RDPOLL/BTG/README.md

BTG  - Batterie Test Gerät

This is to test Battery packs under predefined current, if they reach a certain voltage.
