RDPOLL/BTG/Doku/BTG_Doku/Dokumentation_BTG.docx

Lucas Pollak

Lucas.pollak@ruag.ch

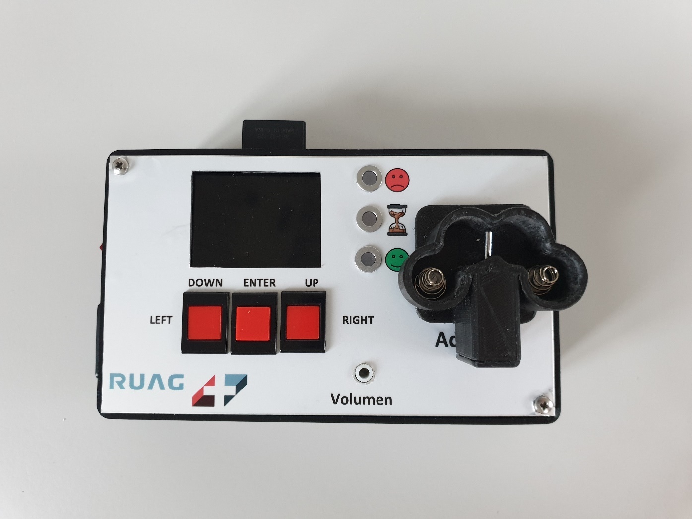
[picture p1: figure]

Batterietestgerät

# 1 Auftrag

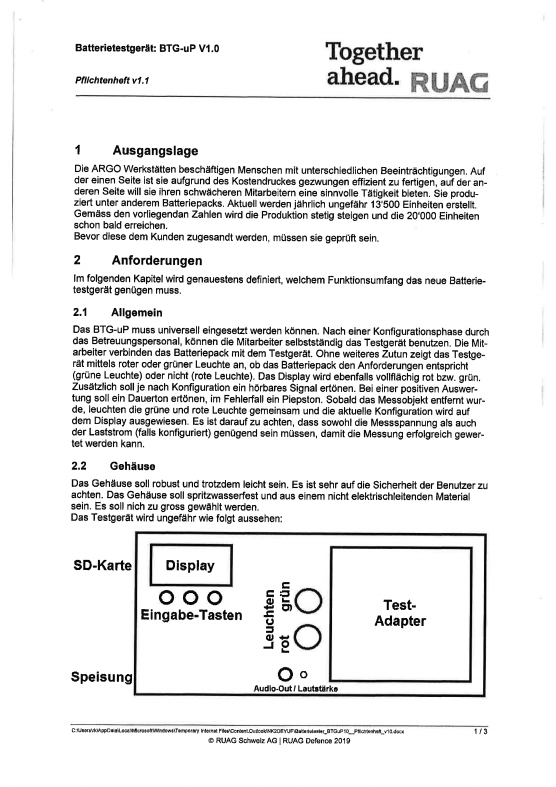
[picture p2: figure]

## 1.1 Pflichtenheft

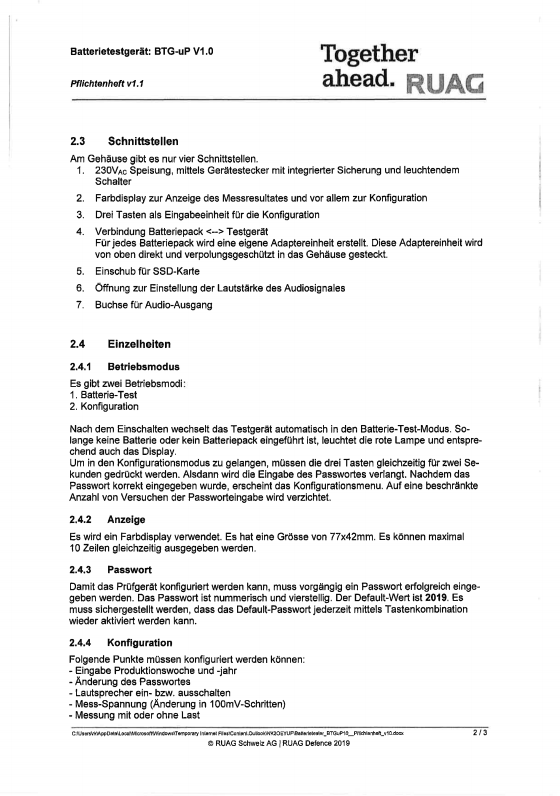
[picture p3: figure]
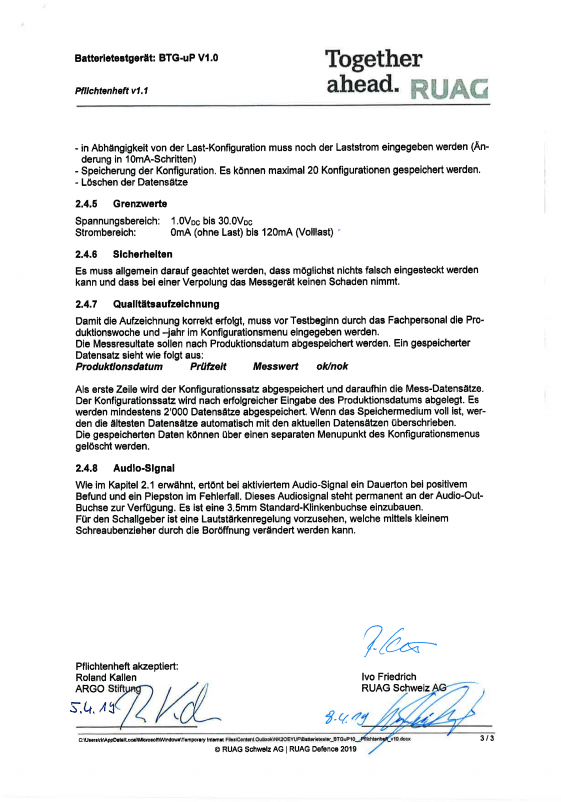
[picture p4: figure]

# 2 Produkt

Das fertige Produkt besteht aus dem Batterietestgerät und der dazugehörigen Software. Dieses Batterietestgerät muss ein Akkupack auf dessen Spannung und Strom überprüfen. Die Akkupacks werden von der AROG Stiftung gefertigt. Das Batterietestgerät sollte aber nicht auf ein Batterietyp festgelegt sein, sondern kann durch einen austauschbaren Messadapter auch verschiedene Batterietyps messen. Nach dem Messen müssen die Messergebnisse auf einem Datenträger abgespeichert werden können.

## 2.1 Hardware

In diesem Abschnitt wird der Hardwareteil des Produktes näher erklärt.

### 2.1.1 Schnittstellen

Zur Bedienung hat das BTG einige Schnittstellen. Zum einen zur Steuerung des Gerätes aber auch zur Stromversorgung.

#### 2.1.1.1 230V

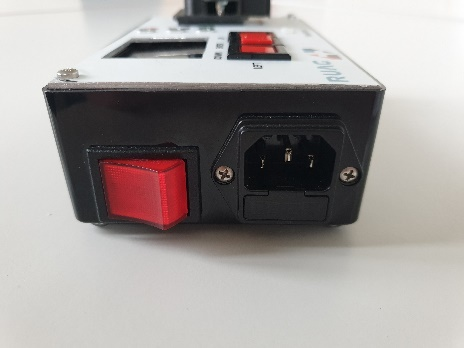
[picture p5: figure]

Die 230 Volt Stromversorgung besteht aus einem Apparatestecker mit integrierten überstromschmelztsicherung. Ein und Aus geschaltet wird das Gerät über den Netzschalter. Dieser trennt das gesamte Gerät von der Speisung. Jegliche Veränderungen an der Speisung müssen mit Abgeschaltetem Gerät getätigt werden.

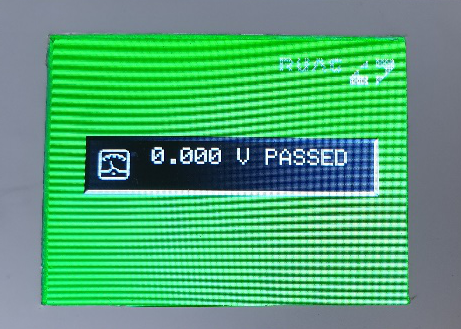
[picture p6: figure]

#### 2.1.1.2 Display

Das Display zeigt den aktuellen Status des Gerätes an. Es werden beim aufstarten allfällige Fehler angezeigt. Wenn das BTG auf eine Batterie wartet zeigt dies das Display auch an. Zum Schluss wird nach einer Messung wird das Ergebnis auf dem Display ausgegeben. Das Display wird vom uC über SPI angesteuert.

#### 2.1.1.3 SD-Karte

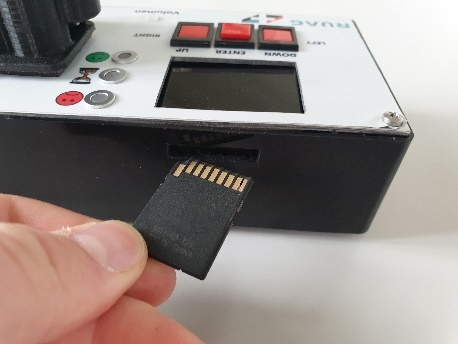
[picture p7: figure]

Der SD-Karten Stecker ist an der Oberseite des Batterietestgerätes erreichbar. (Siehe Bild) Hier muss zur Messung einer Batterie eine SD-Karte mit einem Initialisationsfile (Siehe Bedienungsanleitung) eingesteckt sein. Aufgrund des Aufbaues des SD-Karten Steckers müssen Veränderungen an der SD-Karten (ein- und ausstecken) im Ausgeschalteten Zustand getätigt werden. Ansonsten kann es zu Datenverlusten kommen.

#### 2.1.1.4 Taster & LEDs

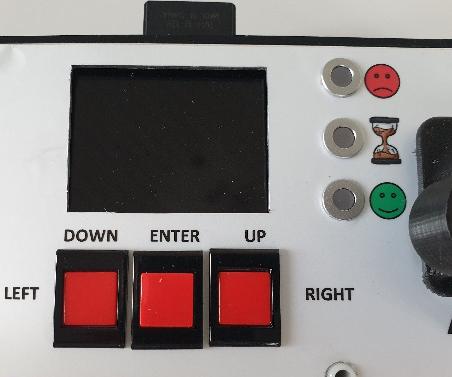
[picture p8: figure]

Zur Steuerung des Gerätes wird ein Taster und drei LEDs verwendet. Optisch sieht es aus als hätte es drei Taster, allerdings ist nur der in der Mitte funktionsfähig. Die äusseren beiden wurden aufgrund ästhetischer Zwecke nicht entfernt. Obwohl der mittler Taster funktionsfähig ist, wird er in der aktuellen Software Version nicht verwendet. Er kann für den Fall in zukünftigen Versionen benutzt werden.

Die drei LEDs haben die Farben Rot, Orange und Grün und werden zur Statusanzeige verwendet. (Siehe Bedienungsanleitung)

#### 2.1.1.5 Messadapter

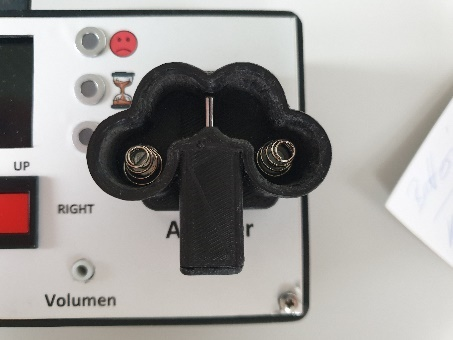
[picture p9: figure]

Zur Messung einer Batterie wird ein Adapter benötigt. Dieser Adapter besteht aus zwei Polen und einem Schalter. Wenn die Batterie in den Messadapter genug tief eingesteckt ist, wird der Schalter betätigt und dadurch die Messung gestartet. Dieser Messadapter kann nach Bedarf ausgetauscht werden, um eine andere Batterie zu messen. Das Layout des Messadaptersteckes ist in Schema ersichtlich.

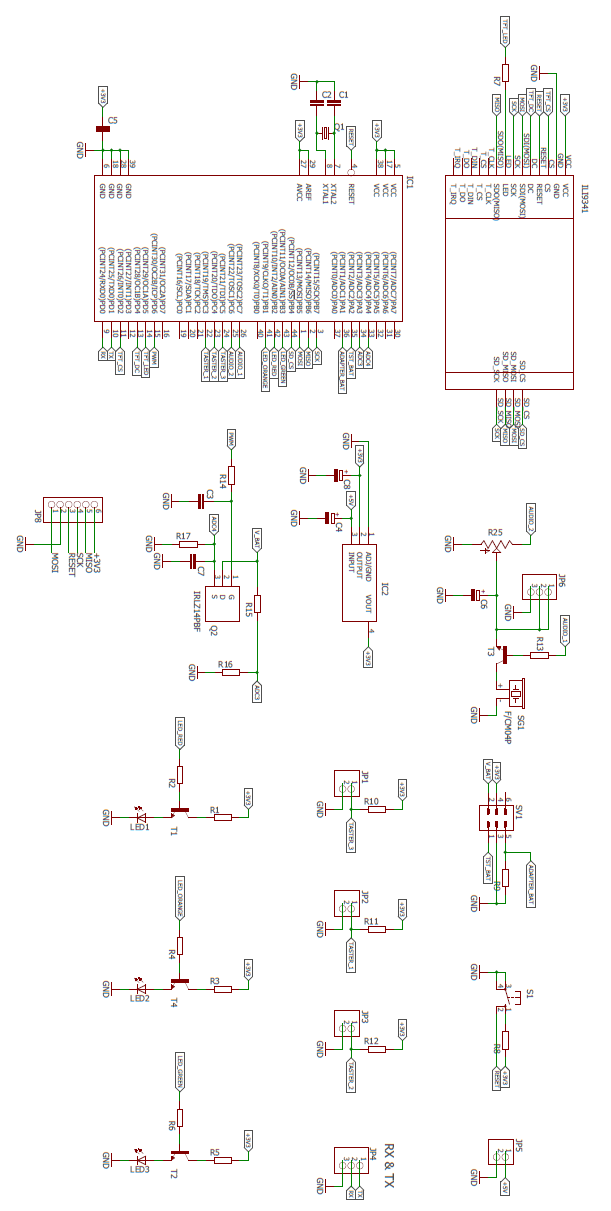
[picture p10: figure]

### 2.1.2 Schema

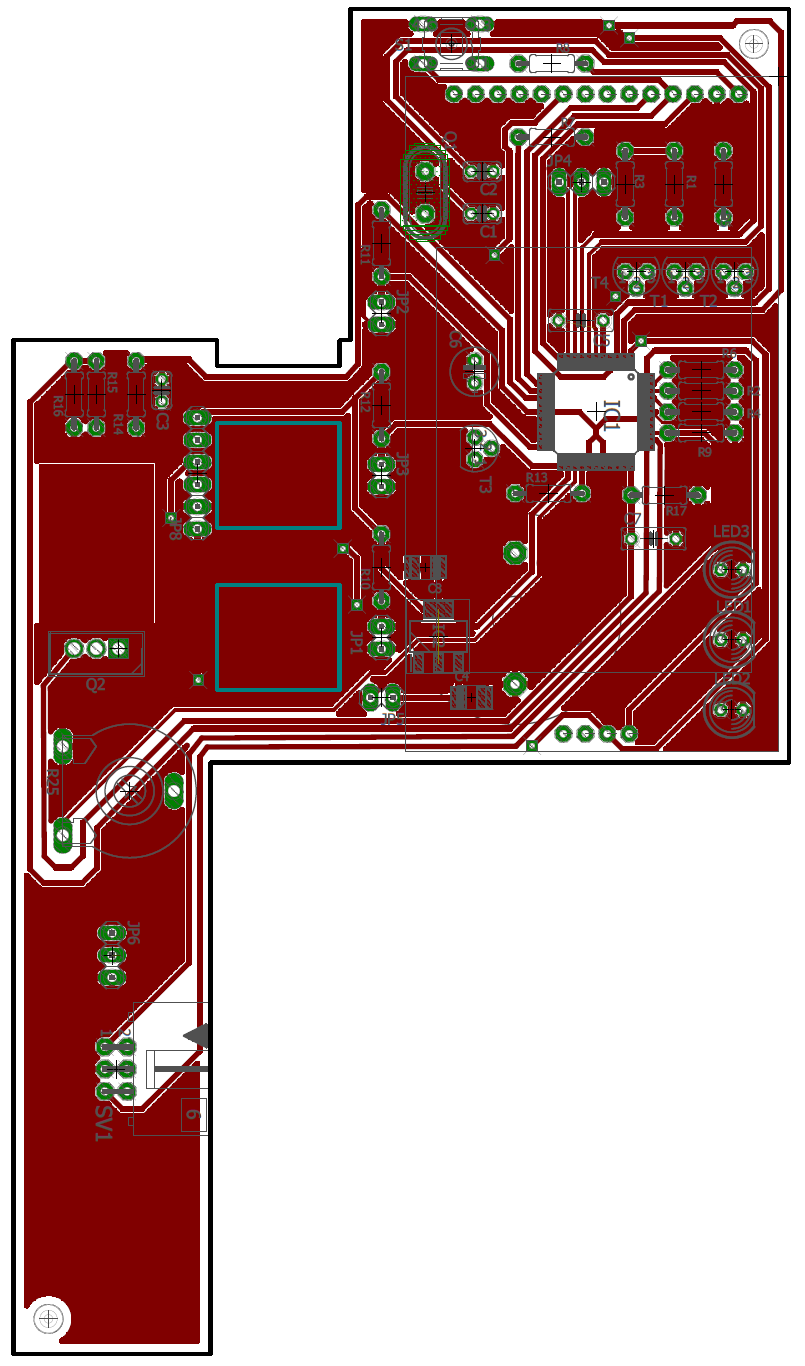
[picture p11: figure]

### 2.1.3 Layout

Top Layer

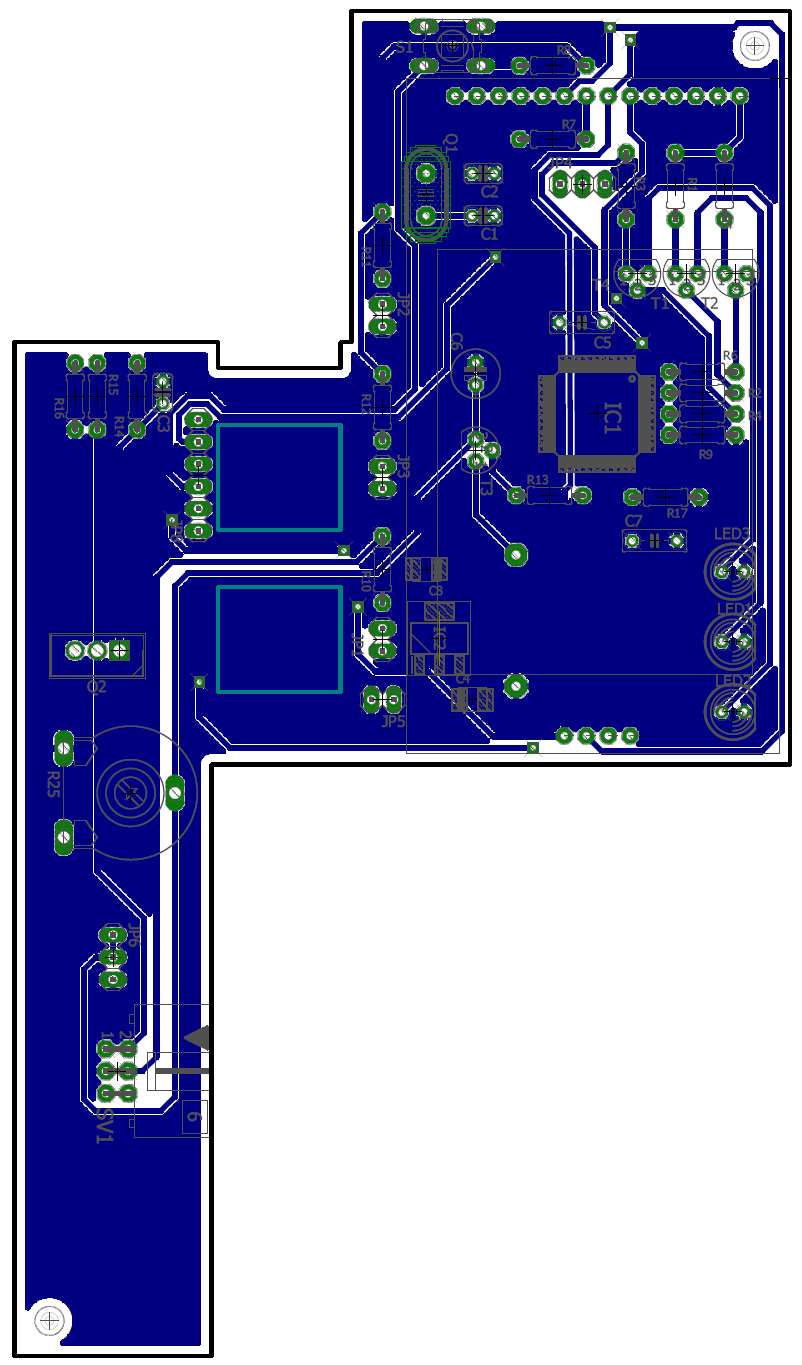
[picture p12: figure]

Bottom Layer

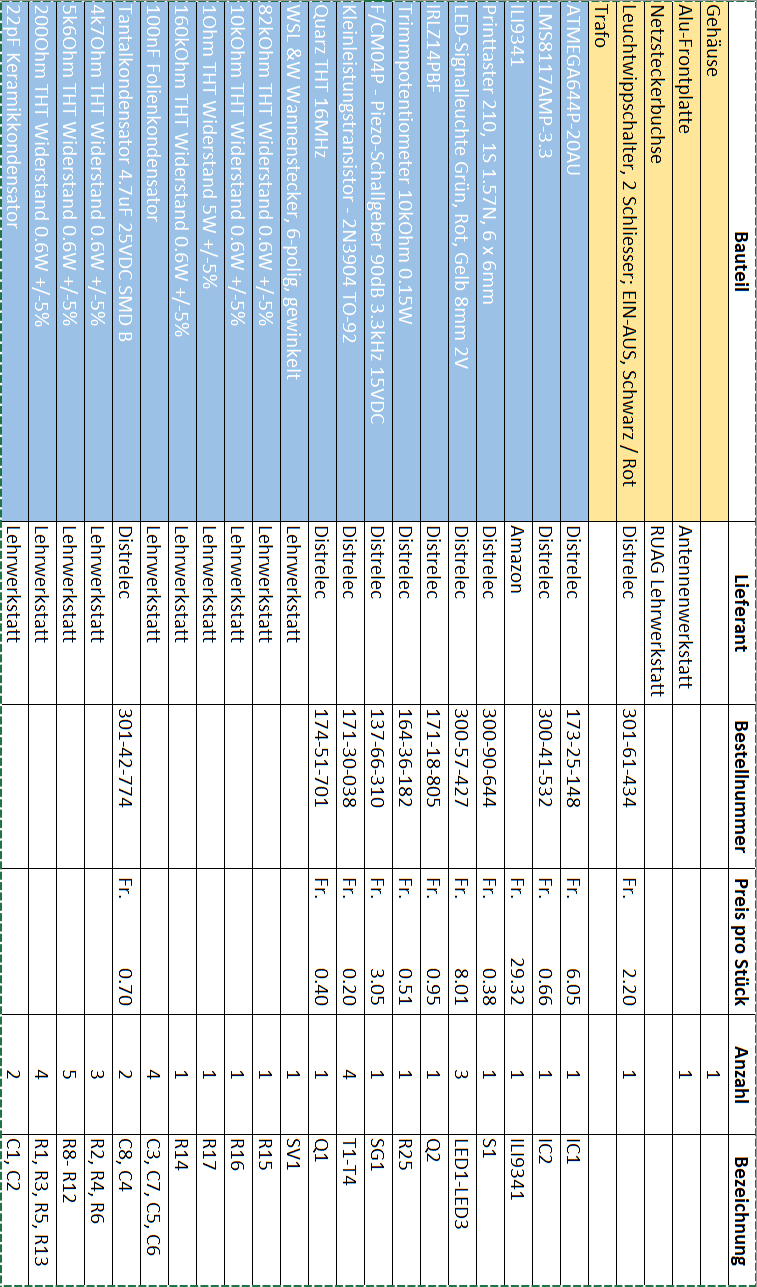
[picture p13: figure]

### 2.1.4 Bauteilliste

## 2.2 Software

### 2.2.1 Werdegang

Da die vorherige Software Version nicht vollständig war, musste diese überarbeitet werden. Die Aktuelle Version wurde von Grund auf neu geschrieben. Nur einzelne Teile wie die Port Initialisierung wurde von der alten übernommen.

Zuerst wurde versucht das Display richtig anzusteuern. Hier wurde festgestellt das in der alten Version die SPI Schnittstelle falsch initialisiert worden war. Als dies behoben wurde lief das Display viel flüssiger. Anschließend wurden Funktionen für die Text und Bild Ausgabe auf dem Display geschrieben und getestet. Somit wurde die ganze grafische Ausgabe effizienter und weniger Fehler anfällig.

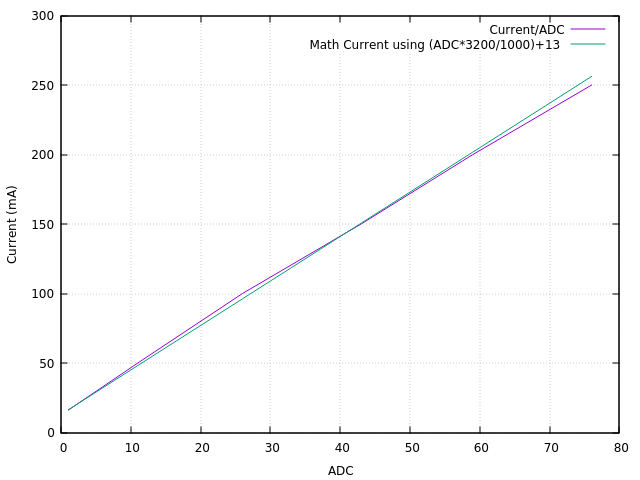
[picture p14: figure]
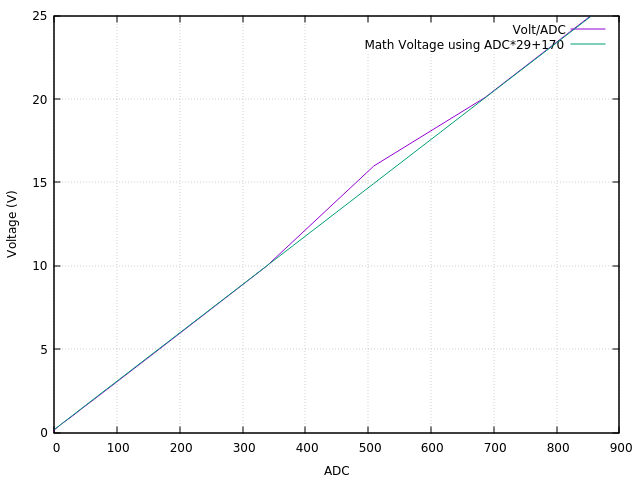
[picture p15: figure]

Im zweiten Schritt wurde Ansteuerung der Messschaltung programmiert. Es wurden die Abhängigkeiten zwischen den ADC und der realen Spannung aufgezeichnet. Anhand dessen konnten die Fehler der ADCs besser kompensiert werden.

Diese Grafiken zeigen den Verlauf der beiden ADC im vergleich zu dem Ergebnis der internen Berechnung der Spannung und des Stromes. Mit Hilfe dieser Formel wird das Messergebnis etwas genauer. Eine ähnliche Messung wurde für das Verhältnis zwischen dem PWM Ausgang und dem Laststrom gemacht. Bei dieser Messung wurde festgestellt, dass der Laststrom verlauf sehr linear im Verhältnis zum PWM Ausgang steht. Aufgrund dessen konnte eine Tabelle erstellt werden, nach welcher der uC den ersten Laststrom setzt. Nach dieser ersten Setzung des PWM Wertes wird dieser anhand des gemessenen Stromes geregelt.

Als letztes wurde die SD-Karte integriert. Als Bibliothek für die SD-Karte wurde die «FatFs - Generic FAT Filesystem Module (http://elm-chan.org/fsw/ff/00index_e.html)» Bibliothek verwendet. Nach dessen Integration konnte die SD-Karte erfolgreich beschrieben und ausgelesen werden. Mit dieser Möglichkeit wurde beschlossen, dass das interne Konfigurationsmenü wegfällt und alles auf die SD-Karte ausgelagert wird. Das bedeutet, dass auf der SD-Karte alle nötigen Konfigurationsdaten in einem File gespeichert werden. Dieses File wird beim aufstarten des BTG ausgelesen und verarbeitet. Mehr zu den nötigen Inhalten dieses Files ist in der Bedienungsanleitung zu finden. Mit dieser Herangehensweise fällt auch ein Passwort für die Konfiguration weg, denn es braucht einen externen Computer, um die Konfigurationsdaten zu ändern.

Der strukturelle Ablauf des Programmes ist auf der nächsten Seite zu finden. Dieses Diagramm sollte helfen den Code zu verstehen.

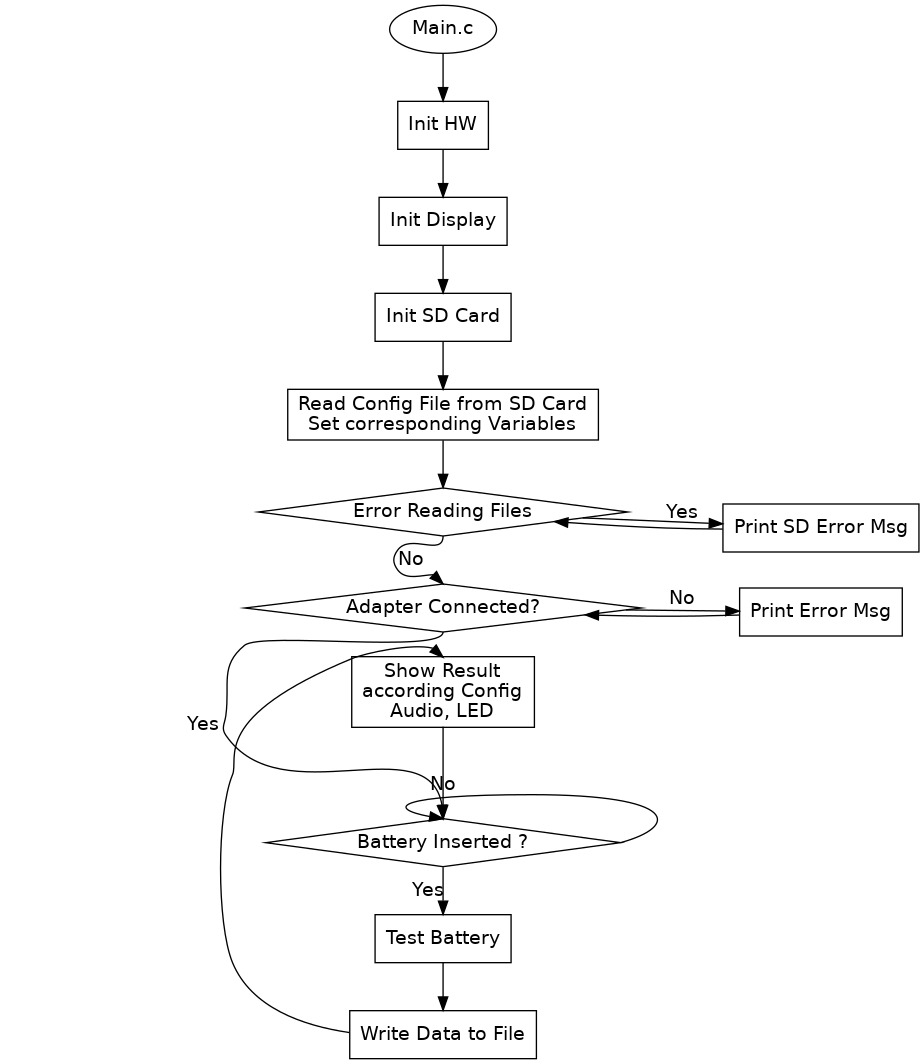
[picture p16: figure]

### 2.2.2 Struktur

# 3 Dokumente

## 3.1 Bedienungsanleitung

### 3.1.1 Wichtige Hinweise

Jegliche Manipulationen mit der SD-Karte müssen bei abgeschalteten Batterietestgerät getätigt werden. Ansonsten kann es zu Datenverlusten kommen.

Die Tasten UP, DOWN und ENTER werden nicht verwendet.

### 3.1.2 Ein-/Ausschalten

Auf der linken Seite der Batterietestgerätes befindet sich eine Apparatesteckerbuchse. In diese wird ein Apparatekabel zur Speisung eingesteckt. Neben der Apparatesteckerbuchse ist der Hauptschalter.

### 3.1.3 Konfiguration

Als erstes entnimmt man die SD-Karte dem abgeschaltetem Batterietestgerät und öffnet mittels eines Computers das read.ini File (siehe SD-Karten Files). In diesem File werden alle nötigen Einstellungen gemacht. Anschliessend wird die SD-Karte vom Computer entfernt und beim abgeschaltetem Batterietestgerät eingesteckt. Das Testgerät wird wieder eingeschaltet und liest automatisch die zuvor definierten Werte ein. Wenn aktiviert, kann die Lautstärke des Piepsers über den Drehwiderstand verändert werden. Hierfür muss ein Schlitzschraubenzier in die Öffnung «Volumen» gesteckt werden.

### 3.1.4 Messung

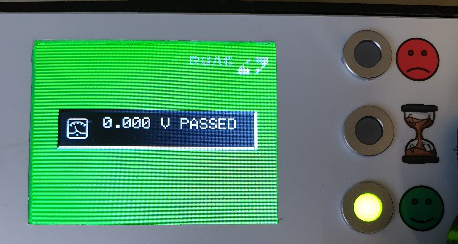
[picture p17: figure]

Das Batterie-Pack wird in den Messadapter vorsichtig eingeführt. Mit einem leichten Druck und dem hör- und spürbarem Klicken des Schalters wird eine Messung gestartet. Die Batterie muss solange gedrückt gehalten werden, bis das Gerät das Ergebnis ausgibt. Während der Messung leuchtet die Orange/Rote LED neben der Sanduhr.

### 3.1.5 Richtiges Messergebnis

Wenn die Batteriespannung über der zuvor definierten Spannung liegt, wird der Bildschirm grün und die grüne LED neben dem lachenden Gesicht leuchtet auf. Zusätzlich kann die akustische Ausgabe aktiviert sein, wodurch bei einem richtigen Messergebnis einen Dauerton ausgeben wird.

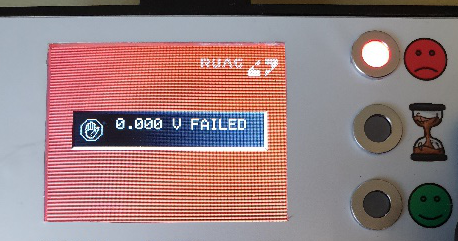
[picture p18: figure]

### 3.1.6 Falsches Messergebnis

Wenn die Batteriespannung unter der definierten Spannung liegt, wird der Bildschirm Rot und die rote LED neben dem traurigen Gesicht leuchtet auf. Auch hier wird, wenn zuvor definiert, ein akustisches Signal ausgegeben. Bei einen Falschen Messergebnis wird ein pulsierender Ton ausgegeben.

### 3.1.7 SD-Karten Files

#### 3.1.7.1 Beschreibung

##### 3.1.7.1.1 Read.ini

Das Batterietestgerät braucht auf der SD-Karte nur das read.ini File. In diesem werden alle Einstellungen definiert.

week = aktuelle Kalenderwoche

year = aktuelles Jahr

name = Name des Angestellten

piezo = akustische Ausgabe aktiv (1) oder nicht aktiv (0)

voltage = Sollspannung der Batterie in mV

current = Laststrom in mA einstellen (für keine Last auf 0 setzen)

Alle nicht erwähnten Werte wie «debug und pwm_offset» sind für Entwicklung zwecke und sollte nicht verändert werden.

##### 3.1.7.1.2 Res.csv

Das Gerät erstellt, falls noch nicht vorhanden, ein Res.csv File. In diesem werden alle Messungen folgen dokumentiert.

Name | Jahr | Kalenderwoche | Laststrom in mA | Gemessene Spannung in mV | Failed/Passed

Beispiel:

Max Muster | 2020 | 46 | 50 | 6115 | Failed

Die Messungen werden nacheinander gespeichert (erste Messung zuoberst). Falls nötig kann das Res.csv File auch gelöscht werden. Das Batterietestgerät erstellt bei der ersten Messung wieder ein Neues File.

#### 3.1.7.2 Read.ini Beispiel File

week = 46

#week number

year = 2020

# year number

name = Max Muster

#name of the user

piezo = 1

debug = 0

pwm_offset = 150

voltage = 10000

current = 50

# 4 Quellenverzeichnis

## 4.1 Code

Der Code ist unter dieser Webseite (https://github.com/RDPOLL/BTG) zu finden:

## 4.2 Dokumentation

Die Dokumentation inklusive Schema und Layout befinden sich im Unterordner Doku (https://github.com/RDPOLL/BTG/tree/main/Doku) auf Github.

Die Dokumentation zur SD-Karten Bibliothek befindet sich auf dieser Webseite (http://elm-chan.org/fsw/ff/00index_e.html).
