RDPOLL/BTG/Doku/BTG_Doku/Gehäuse/Folie_V2.pdf

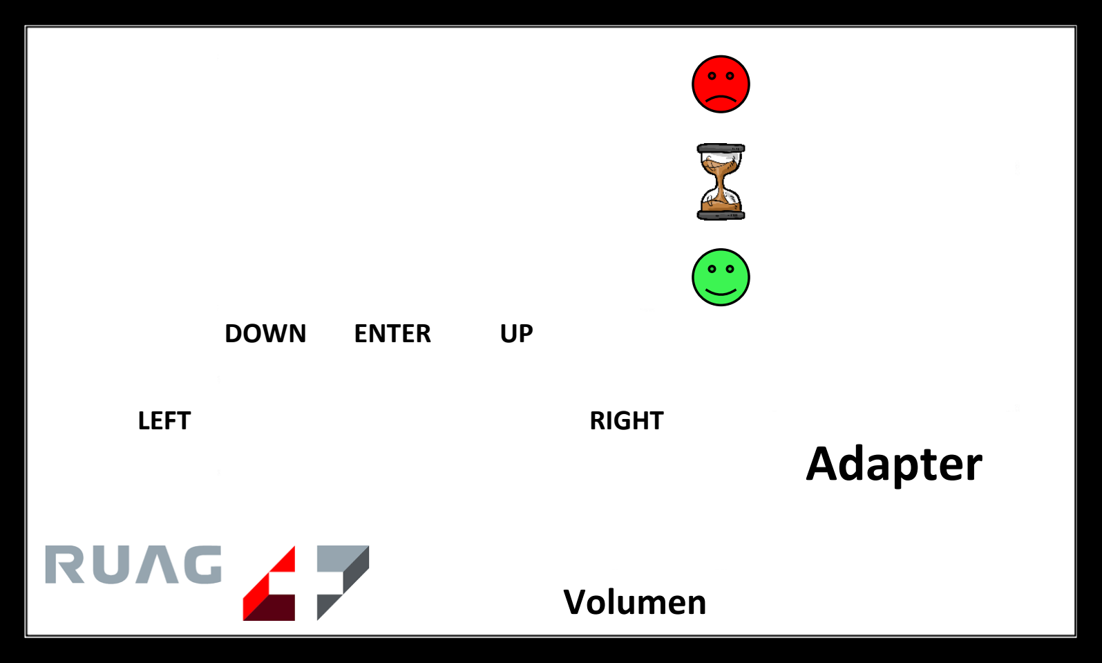
[picture p19: figure]
Adapter; Volumen; DOWN; ENTER; LEFT; RIGHT
