RDPOLL/BTG/Doku/BTG_Doku/Vorlagen_Auftragsgeber/Pflichtenheft.pdf

Batterietestgerät: BTG-uP Vl.0

Pfllchtenheft v|.1

# Together

# ahead. RUAG

## I Ausgangslage

Die ARGO Werkstätten beschäftigen Menschen mit unterschiedlichen Beeinträchtigungen. Auf der einen Seite ist sie aufgrund des Kostendruckes gezwungen effizient zu fertigen, auÍ der anderen Seite willsie ihren schwächeren Mitarbeitern eine sinnvolle Tåitigkeit bietèn. Sie produziert unter anderem Batteriepacks, Aktuell werden jährlich ungefähr 13'500 Einheiten erstellt, Gemäss den vorliegendan Zahlen wird die Produktion stetig steigen und die 2O'OOO Einheiten schon bald erreichen.
Bevor diese dem Kunden zugesandt werden, müssen sie geprüft sein.

## 2 Anforderungen

lm folgenden Kapitelwird genauestens definiert, welchem Funktionsumfang das neue Batterietestgerät genügen muss,

### 2.1 Allgemein

Das BTG-uP muss universell eingesetzt werden können. Nach einer Konfigurationsphase durch das Betreuungspersonal, können die Mítarbeiter selbstständig das Testgerät benutzen, Die Mitarbeiter verbinden das Batteriepack mit dem Testgerät. Ohne weiteres Zutun zeigt das Testgerät mittels roter oder grilner Leuchte an, ob das Batteriepack den Anforderungen entspricht

(grüne Leuchte) oder nicht (rote Leuchte). Das Display wird ebenfalls vollflächig rot bzw. grün. Zusätzlich sollje nach Konfiguration ein hÖrbares Signal ertönen. Bei einer positiven Auswertung soll ein Dauerton ertönen, im Fehlerfall ein Piepston. Sobald das Messobjekt entfernt wurde, leuchten die grûne und rote Leuchte gemeinsam und die aktuelle Konfígurâtion wird auf dem Dísplay ausgewiesen, Es ist darauf zu achten, dass sowohldie Messspannung als auch der Laststrom (falls konfiguriert) genügend sein müssen, damit die Messung erfolgreich gewertet werden kann.
2.2 Gehäuse

Das Gehäuse soll robust und trotzdem leicht sein. Es ist sehr auf die Sicherheit der Benutzer zu achten. Das Gehäuse soll spritzwasserfest und aus einem nicht elektrischleitenden Material sein. Es soll nich zu gross gewählt werden.
Das Testgerät wird ungefähr wie folgt aussehen:

## SD-Karte

## Speisung

## Test-

## Adapter

## Display

tr
E¡J
#b

o
J
-3H
o o

Audio-Out I Lautstärka

# ooo

## Eingabe-Tasten

Clusor8vklqppDåtê\Lo€lv\rlc¡o3off\Wndow6\Tomporâry lnternet Filos\Conlenl.Oullook\NK2OEYUF\BatterletóstgLBlcuPlo_pfllch(enhett-vl 0docx
@ RUAG Schweiz AG I RUAG Defence 2019

1t3

Batterietestgerät: BTG-uP V1 .0

Pflìchtenheft v1.1

# Together

# ahead.RUAC

### 2.3 Schnittstellen

Am Gehäuse gibt es nur vier Schnittstellen.
1, 230V¡c Speisung, mittels Gerätestecker mit integrierter Sicherung und leuchtendem Schalter
2. Farbdisplay zur Anzeige des Messresultates und vor allem zur Konfiguration
3, Drei Tasten als Eingabeeinheit für die Konfiguration
4. Verbindung Batteriepack <--> Testgerät
Für jedes Batteriepack wird eine eigene Adaptereinheit erstellt, Diese Adaptereinheit wird von oben direkt und verpolungsgeschritzt in das Gehäuse gesteckt,
5. Einschub für SSD-Karte
6. Öffnung zur Einstellung der Lautstärke des Audiosignales
7. Buchse für Audio-Ausgang

2.4 Einzelheiten

2.4.'l Betriebsmodus

Es gibt a¡rei Betriebsmodi
l. Batterie-Test
2. Konfiguration

Nach dem Einschalten wechselt das Testgerät automatisch in den Batterie-TesþModus. Solange keíne Batterie oder kein Batteriepack eingeflihrt ist, leuchtet die rote Lampe und entsprechend auch das Display,
Um in den Konfigurationsmodus zu gelangen, müssen die drei Tasten gleichzeitig für zwei Sekunden gedrtlckt werden. Alsdann wird die Eingabe des Passwortes verlangt. Nachdem das Passwort konekt eingegeben wurde, erscheint das Konfigurationsmenu. Auf eine beschränkte Anzahl von Versuchen der Passworteingabe wird vezichtet.
2.4.2 Anzeige

Es wird ein Farbdisplay verwendet. Es hat eine Grösse von77x42mm, Es können maximal 10 Zeilen gleichzeitig ausgegeben werden,
2.4.3 Passwort

Damit das Prüfgerät konfiguriert werden kann, muss vorgängig ein Passwort erfolgreich eingegeben werden. Das Passwort ist nummerisch und vierstellig, Der Default-Wert ist 2019. Es muss sichergestellt werden, dass das Default-Passwort jederzeit mittels Tastenkombination wieder aktiviert werden kann.
2.4.4 Konfiguration

Folgende Punkte müssen konfiguríert werden können:
- Eingabe Produktionswoche und -jahr
-,Anderung des Passwortes
- Lautsprecher ein- bzw. ausschalten
- Mess-spannung (Anderung in 1OOmV-schritten)
- Messung mit oder ohne Last

ClUs€ËVk\AppDEta\Lo€l\f\¡lrcsoflNvlndowr\T6mporary lntsrnÊt Flles\Conlenl.Oullook\NK2OEYUF\Bstl€letest€r-BTGUPIO_Pll¡chlênhslt-v10-dod
@ RUAG Schweiz AG IRUAG Defence 2019

Batterletestgerät: BTG-uP Vl.0

Pfllchtenhelt v1,1

# Together

# ahead.F1UAG

- in Abhångigkeit von der Last-Konfiguration muss noch der Laststrom eingegeben werden (Änderung in I OmA-Schritten)
- Speicherung der Konfiguration. Es können maximal 20 Konfigurationen gespeichert werden.
- Löschen der Datensätze
2,4.6 Grenarerte
Spannungsbereich: 1.OVoc bis30.0Voc
Strombereich: OmA (ohne Last) bis 120m4 (Volllast) "
2.4.6 Slcherhelten

Es muss allgemein darauf geachtet werden, dass möglichst nichts falsch eingesteckt werden kann und dass bei einer Verpolung das Messgerät keinen Schaden nimmt,
2.4.7 Qualltätsaufzelchnung

Damit die Aufzeichnung korrekt erfolgt, muss vor Testbeginn durch das Fachpersonal die Produktionswoche und -jahr im Konfigurationsmenu elngegeben werden.
Die Messresultate sollen nach Produktionsdatum abgespeichert werden. Ein gespeicherter Datensatz sieht wie folgt aus:

## Produktlonsdatum Prllfzelt Messwert oklnok

Als erste Zeile wird der Konfigurationssatz abgespeichert und daraufhin die Mess-Datensätze. Der Konfigurationssatz wird nach erfolgreicher Eingabe des Produktionsdatums abgelegt. Es werden mindestens 2'000 Datensåtze abgespeichert. Wenn das Speichermedium voll ist, werden die ältesten Datensåtze automatisch mit den aktuellen Datensåtzen überschrieben.
Die gespeicherten Daten können flber einen separaten Menupunkt des Konfigurationsmenus gelöscht werden.
2.4,8 Audlo-Slgnal

Wie im Kapitel 2.1 erwähnt, ertönt bei aktíviertem Audio-Signal ein Dauerton bei positlvem Befund und ein Piepston im Fehlerfall, Dieses Audiosignal steht permanent an der Audio-Out-Buchse zur Verfügung. Es ist eine 3,Smm Standard-Klinkenbuchse einzubauen.
Ft¡r den Schallgeber ist eine Lautstärkenregelung vozusehen, welche mittels kleinem Schreaubenzieher durch die BorÖffnung verändert werden kann,

Pf lichtenheft akzeptiert: Roland Kallen
ARGO
.S.{4. /Í

lvo Friedrich
RUAG Schweiz

C'\ulofiVt\AppDlblloúllrrlþþloli\Wndwr\Tåmponry lnlm.l

## fl-cl

@ RUAG Schwelz AG I RUAG Debnce 2019
