RDPOLL/BTG/Doku/BTG_Doku/Vorlagen_Auftragsgeber/Zeichnung_Batteriepack.pdf

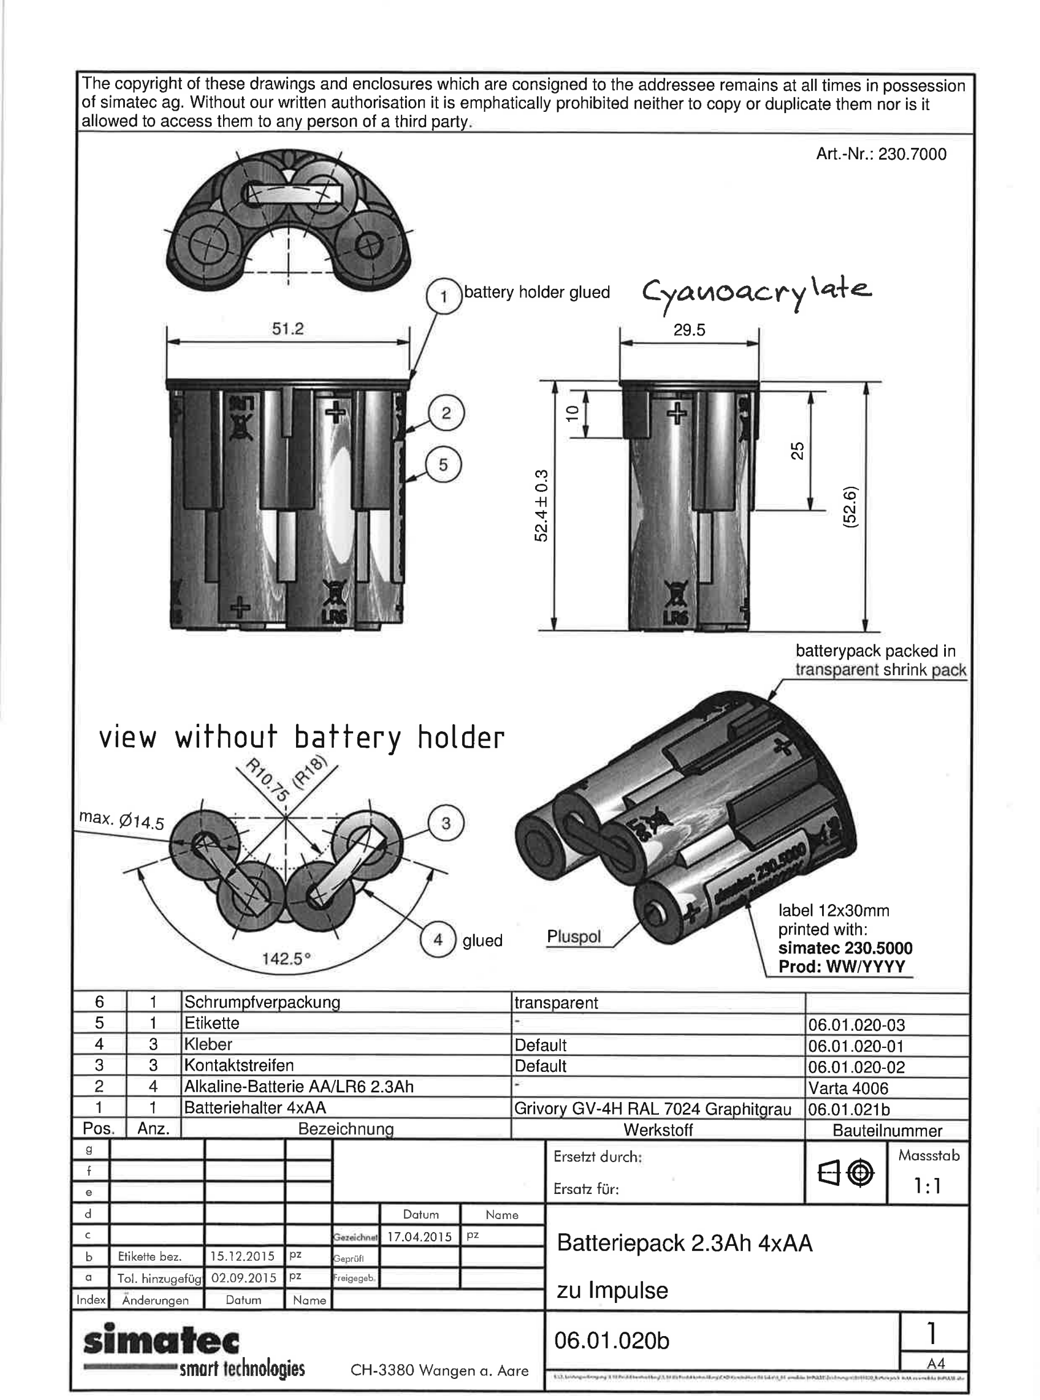
[picture p20: page 1]
