RDPOLL/BTG/Doku/BTG_Doku/Schema_Print_ect/Bauteilliste.xlsx

Bauteil | Lieferant | Bestellnummer | Preis pro Stück | Anzahl | Bezeichnung
Gehäuse |  |  |  | 1
Alu-Frontplatte | Antennenwerkstatt |  |  | 1
Netzsteckerbuchse | RUAG Lehrwerkstatt
Leuchtwippschalter, 2 Schliesser; EIN-AUS, Schwarz / Rot | Distrelec | 301-61-434 | Fr.2.20 | 1
Trafo
ATMEGA644P-20AU | Distrelec | 173-25-148 | Fr.6.05 | 1 | IC1
LMS8117AMP-3.3 | Distrelec | 300-41-532 | Fr.0.66 | 1 | IC2
ILI9341 | Amazon |  | Fr.29.32 | 1 | ILI9341
Printtaster 210, 1S 1.57N, 6 x 6mm | Distrelec | 300-90-644 | Fr.0.38 | 1 | S1
LED-Signalleuchte Grün, Rot, Gelb 8mm 2V | Distrelec | 300-57-427 | Fr.8.01 | 3 | LED1-LED3
IRLZ14PBF | Distrelec | 171-18-805 | Fr.0.95 | 1 | Q2
Trimmpotentiometer 10kOhm 0.15W | Distrelec | 164-36-182 | Fr.0.51 | 1 | R25
F/CM04P - Piezo-Schallgeber 90dB 3.3kHz 15VDC | Distrelec | 137-66-310 | Fr.3.05 | 1 | SG1
Kleinleistungstransistor - 2N3904 TO-92 | Distrelec | 171-30-038 | Fr.0.20 | 4 | T1-T4
Quarz THT 16MHz | Distrelec | 174-51-701 | Fr.0.40 | 1 | Q1
WSL &W Wannenstecker, 6-polig, gewinkelt | Lehrwerkstatt |  |  | 1 | SV1
82kOhm THT Widerstand 0.6W +/-5% | Lehrwerkstatt |  |  | 1 | R15
10kOhm THT Widerstand 0.6W +/-5% | Lehrwerkstatt |  |  | 1 | R16
1Ohm THT Widerstand 5W +/-5% | Lehrwerkstatt |  |  | 1 | R17
160kOhm THT Widerstand 0.6W +/-5% | Lehrwerkstatt |  |  | 1 | R14
100nF Folienkondensator | Lehrwerkstatt |  |  | 4 | C3, C7, C5, C6
Tantalkondensator 4.7uF 25VDC SMD B | Distrelec | 301-42-774 | Fr.0.70 | 2 | C8, C4
4k7Ohm THT Widerstand 0.6W +/-5% | Lehrwerkstatt |  |  | 3 | R2, R4, R6
5k6Ohm THT Widerstand 0.6W +/-5% | Lehrwerkstatt |  |  | 5 | R8- R12
200Ohm THT Widerstand 0.6W +/-5% | Lehrwerkstatt |  |  | 4 | R1, R3, R5, R13
22pF Keramikkondensator | Lehrwerkstatt |  |  | 2 | C1, C2
