RDPOLL/BTG/Doku/BTG_Doku/Messadapter/Deckel_Schalter.stl

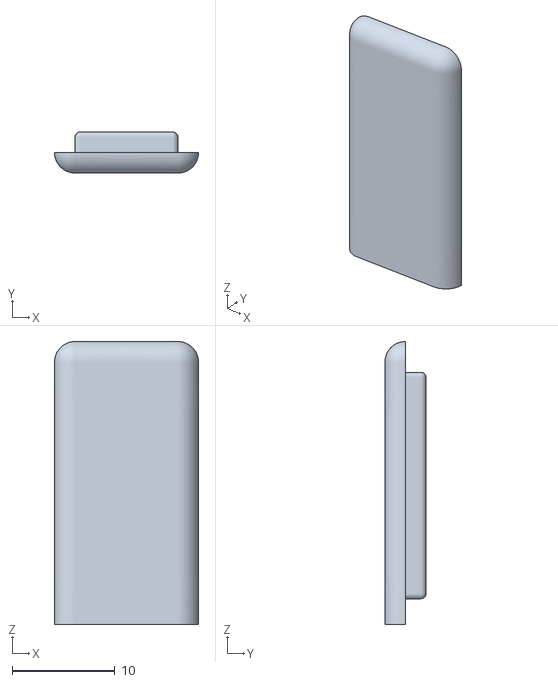
[picture p21: CAD file, 2020-12-02]
Doku/BTG_Doku/Messadapter/Deckel_Schalter.stl
14.0 x 4.00 x 27.5
