RDPOLL/BTG/Doku/BTG_Doku/Messadapter/Adapter_6V.stl

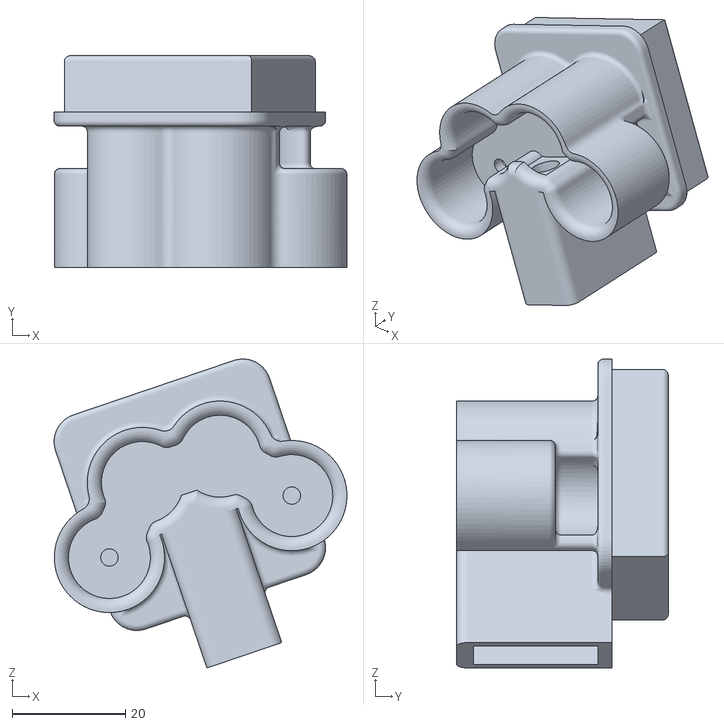
[picture p22: CAD file, 2020-12-02]
Doku/BTG_Doku/Messadapter/Adapter_6V.stl
51.8 x 37.5 x 54.7
