RDPOLL/BTG/(list of files, cad)

Other CAD files:
Doku/BTG_Doku/Gehäuse/Batterietestgeraet_Aluplatte.ipt
