RDPOLL/BTG/Doku/BTG_Doku/Schema_Print_ect/Bauteilliste.PNG

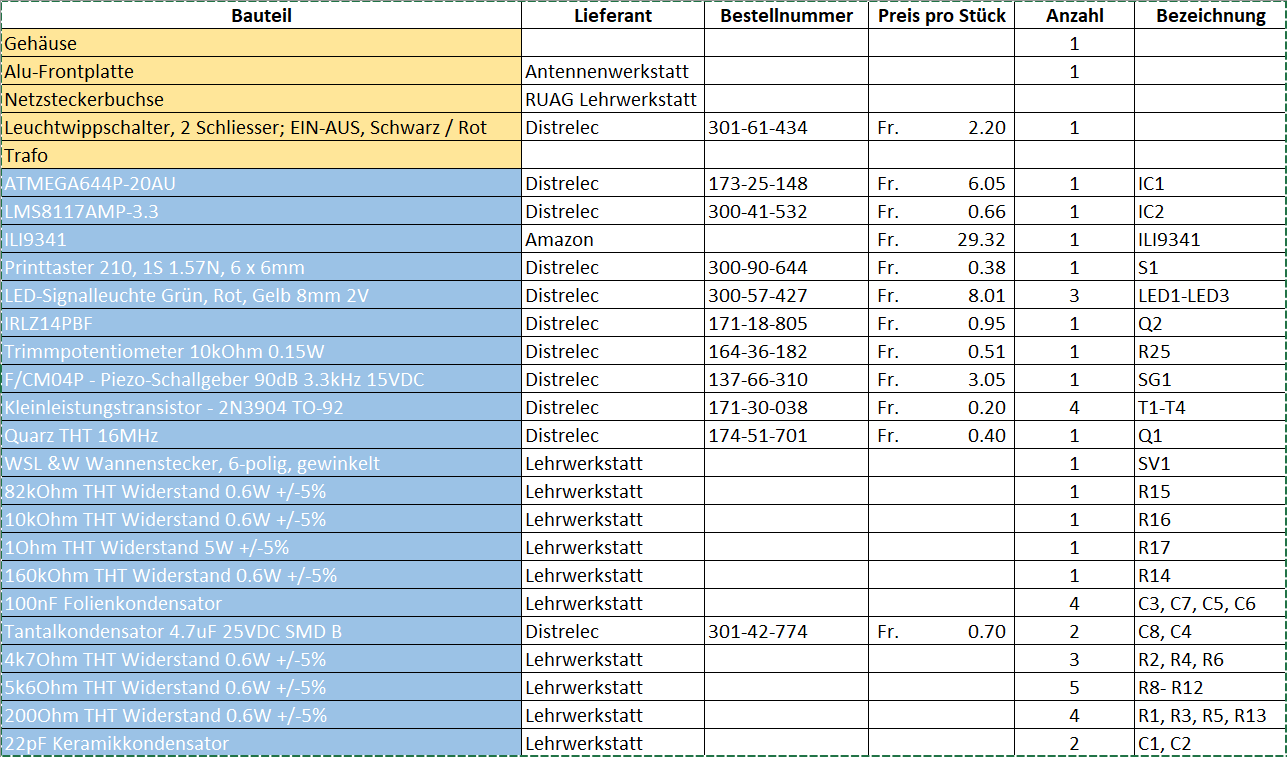
Doku/BTG_Doku/Schema_Print_ect/Bauteilliste.PNG
