RDPOLL/BTG/Doku/BTG_Doku/Schema_Print_ect/Schema/BTG.PNG

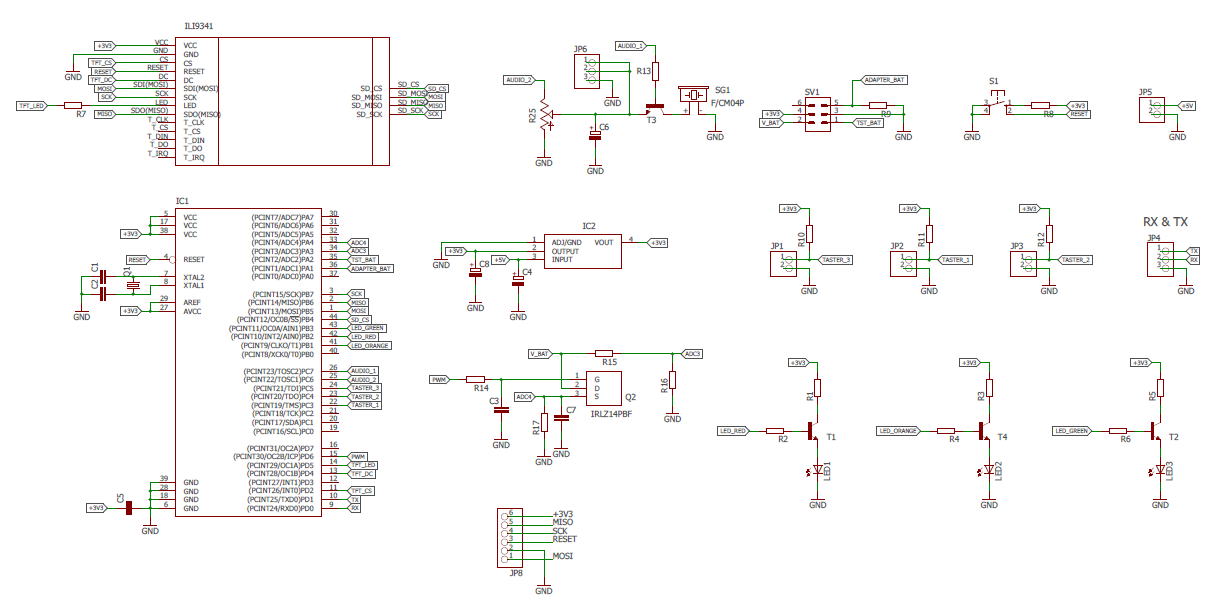
Doku/BTG_Doku/Schema_Print_ect/Schema/BTG.PNG
