RDPOLL/BTG/Doku/BTG_Doku/Schema_Print_ect/Layout/Bottom.pdf

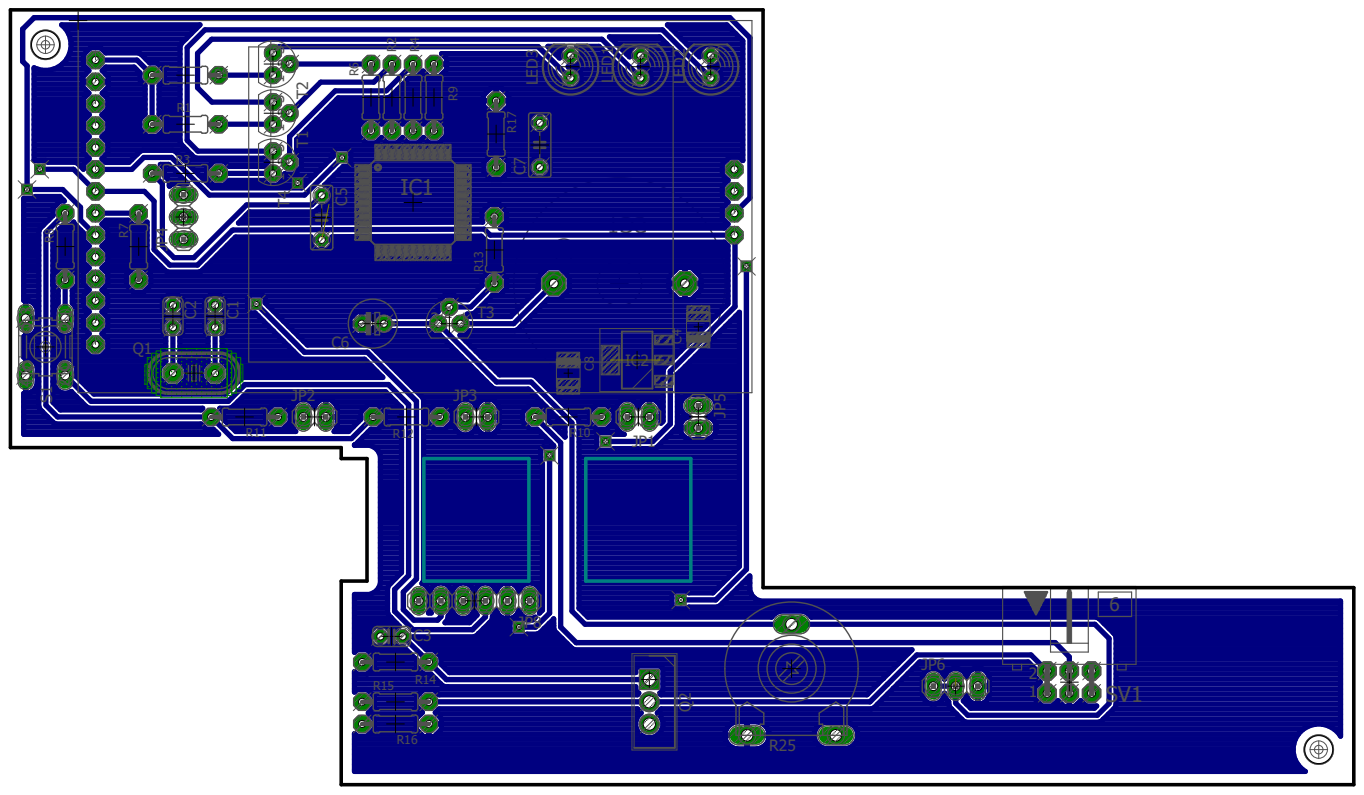
[picture p25: page 1]
