RDPOLL/BTG/Doku/BTG_Doku/Schema_Print_ect/Layout/Top.pdf

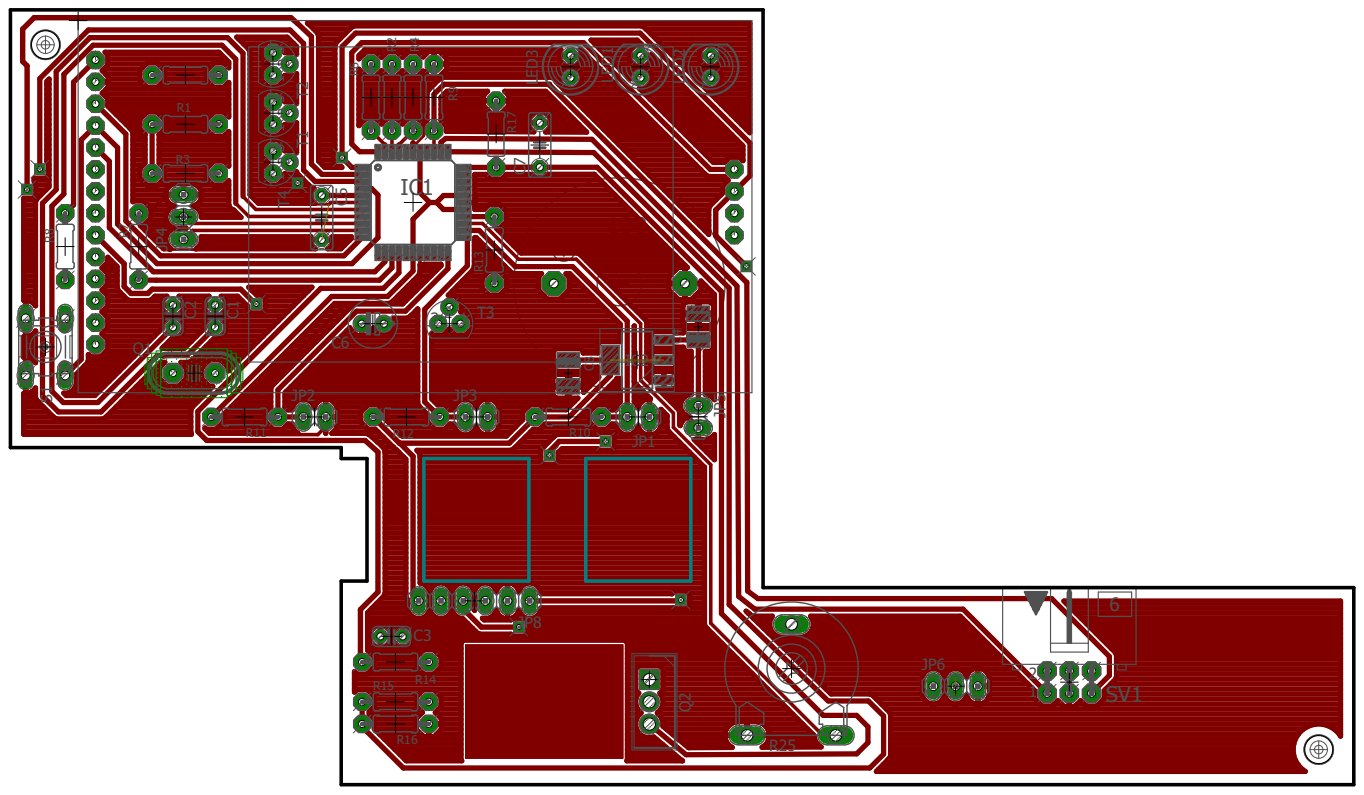
[picture p26: page 1]
