RDPOLL/BTG/Doku/BTG_Doku/Schema_Print_ect/Schema/BTG.pdf

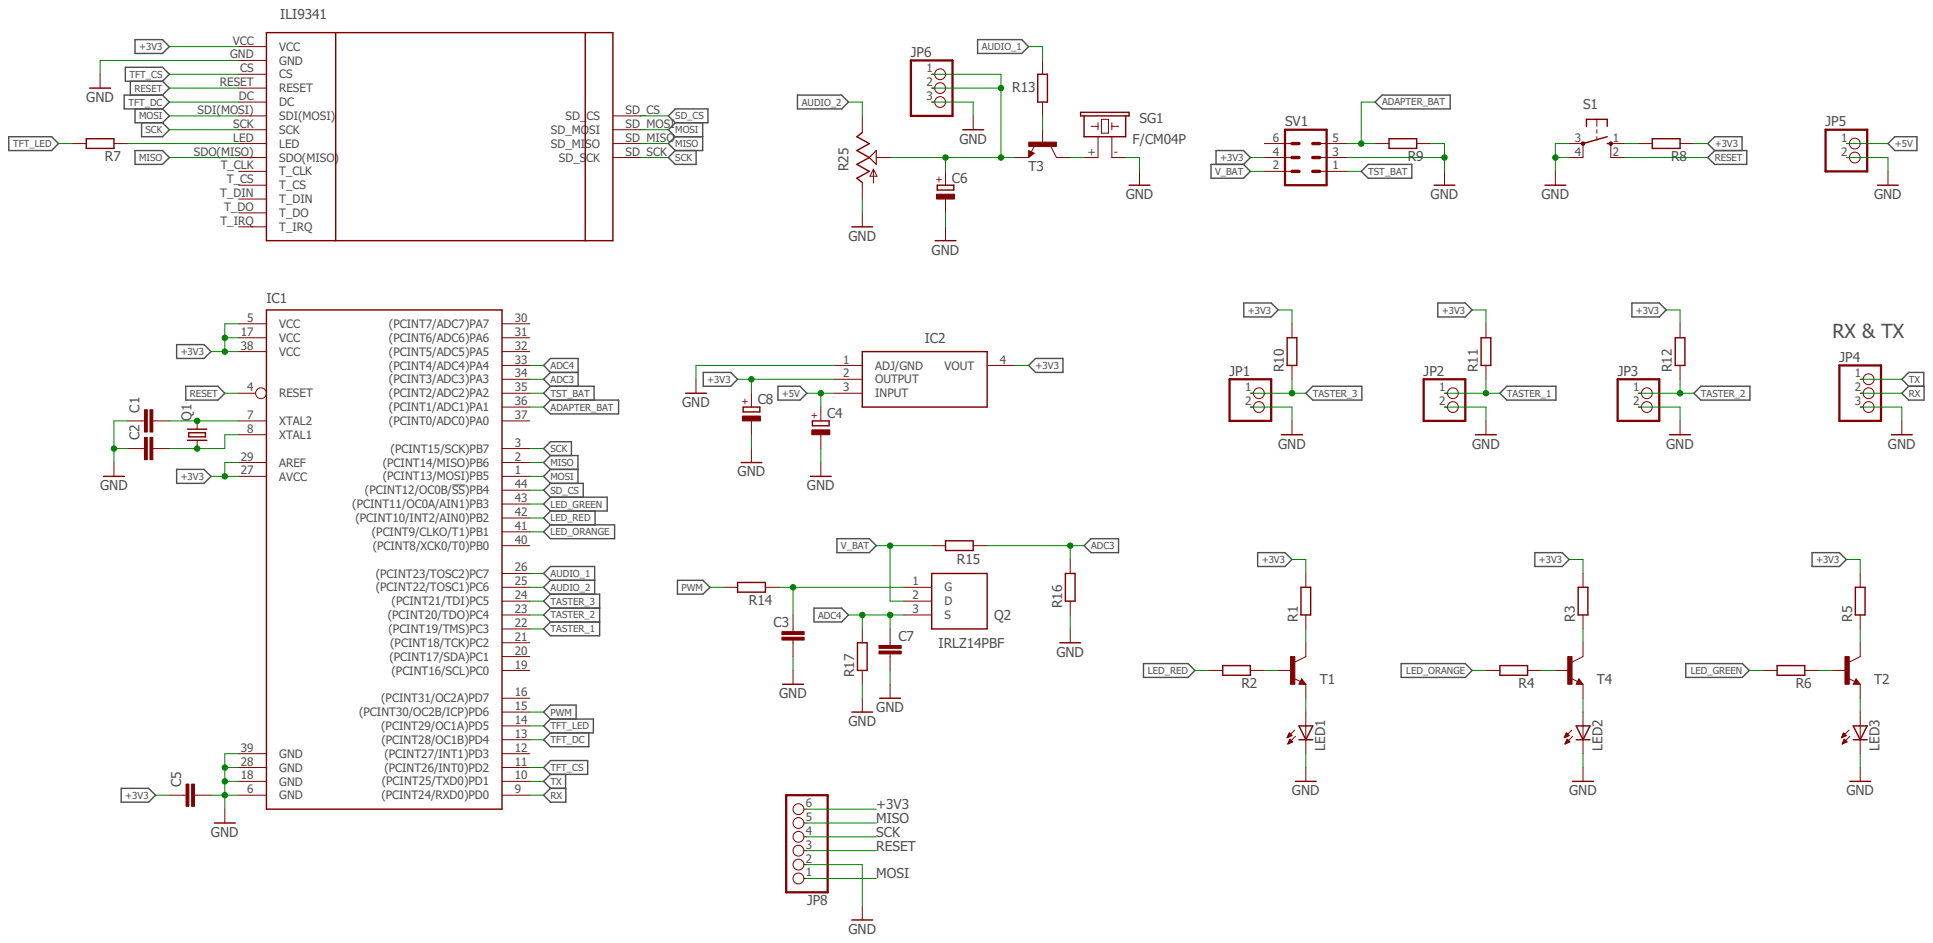
[picture p27: page 1]
