RDPOLL/BTG/Doku/BTG_Doku/Schema_Print_ect/Eagle/BTG.brd

## EAGLE design Doku/BTG_Doku/Schema_Print_ect/Eagle/BTG.brd (2020-12-02)

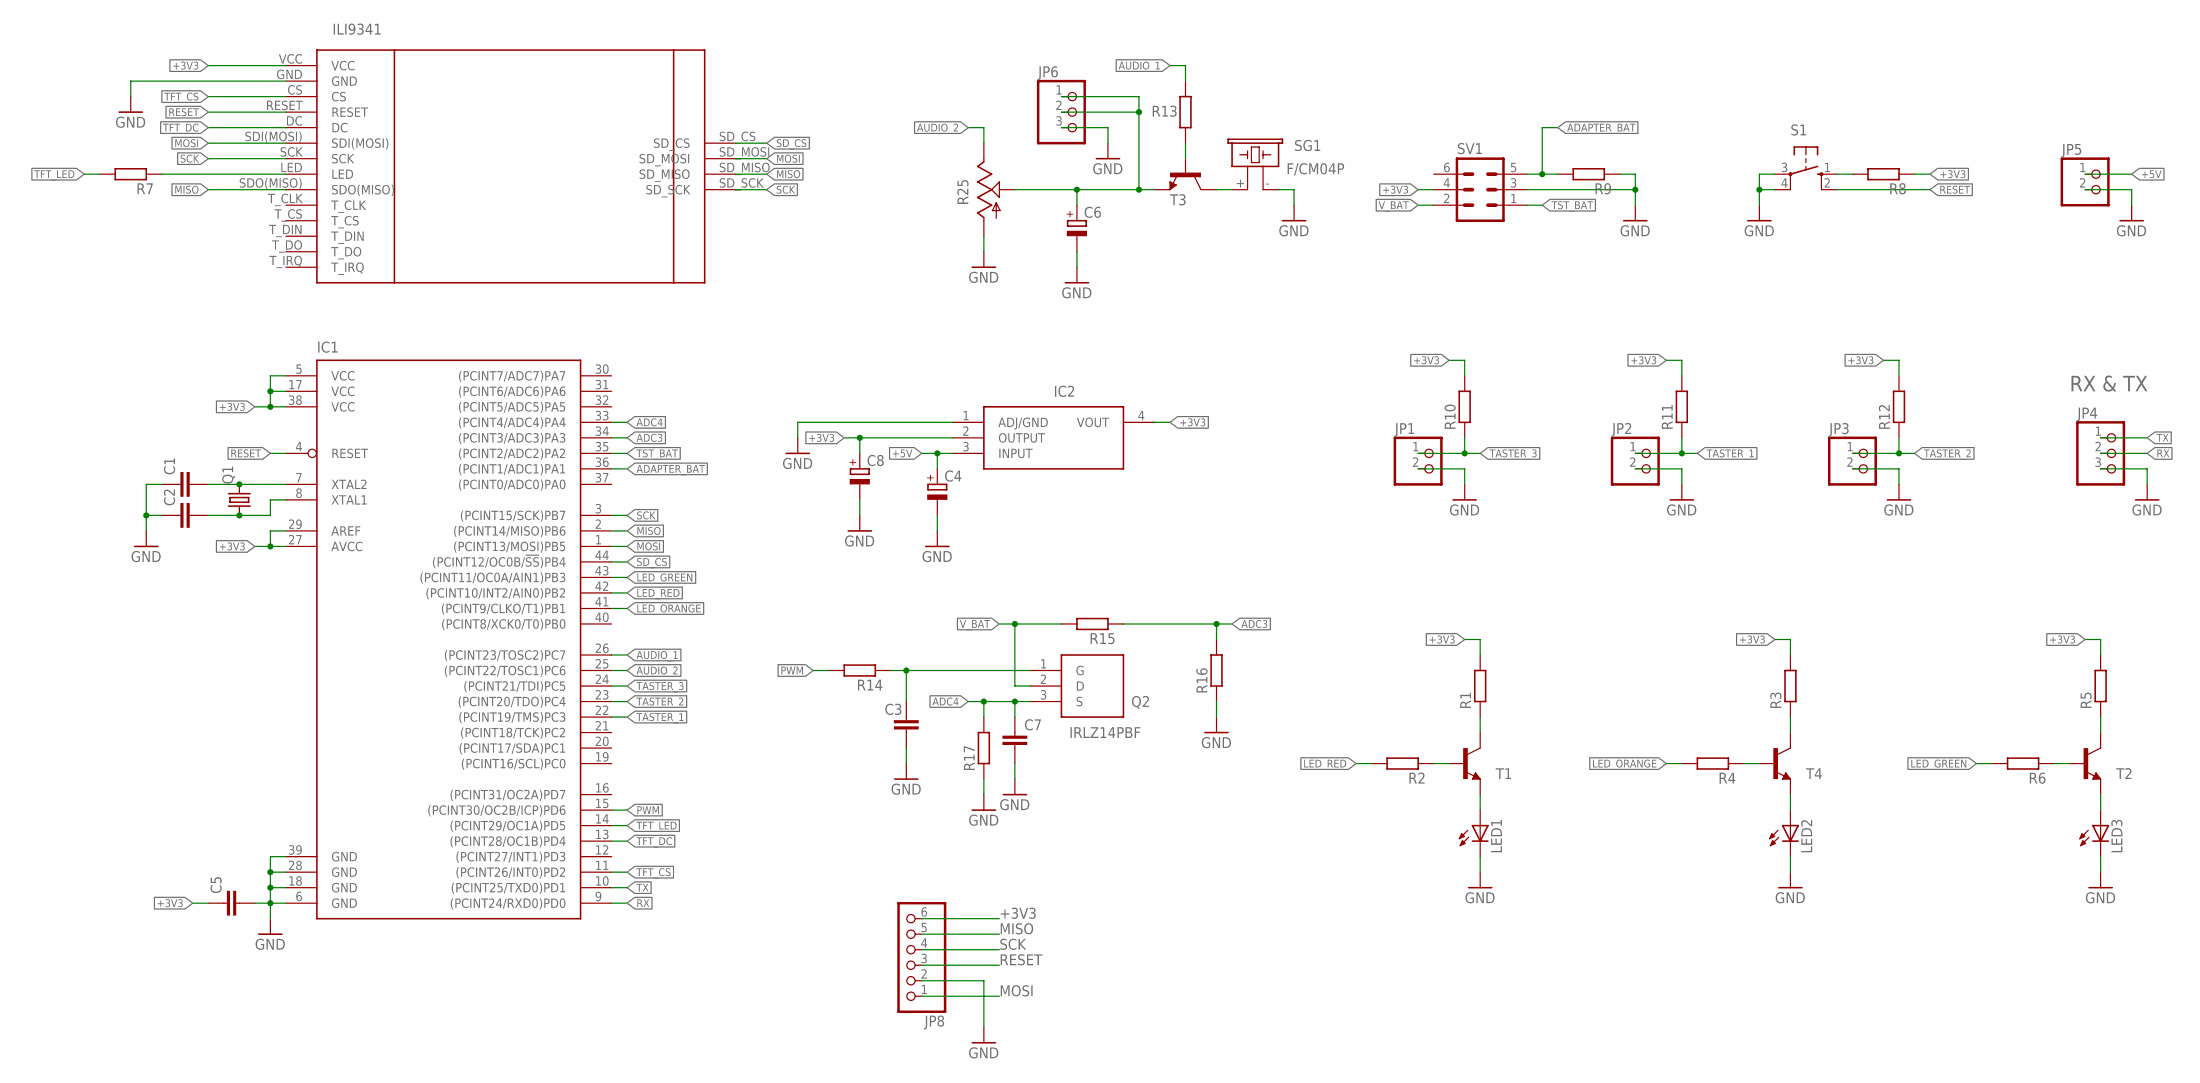
[picture p28: schematic BTG.sch]

Parts:
C1, C2, C3: C-EU025-024X044; C025-024X044
C4, C8: CPOL-EUSMCB; SMC_B
C5, C7: C-EU050-025X075; C050-025X075
C6: CPOL-EUE2,5-6E; E2,5-6E
IC1: ATMEGA644A; TQFP44
IC2: LMS8117AMP-3.3_NOPB; SOT230P700X180-4N
JP1, JP2, JP3, JP5: PINHD-1X2; 1X02
JP4, JP6: PINHD-1X3; 1X03
JP8: PINHD-1X6; 1X06
LED1, LED2, LED3: LED5MM
Q1: CRYSTALHC49U-V; HC49U-V
Q2: IRLZ14PBF; TO254P465X1031X1954-3P
R1, R2, R3, R4, R5, R6, R7, R8, R9, R10, R11, R12, R13, R14, R15, R16, R17: R-EU_0204/7; 0204/7
R25: TRIM_US-LI15; LI15
S1: 10-XX; B3F-10XX
SG1: F/CM04P
SV1: ML6L
T1, T2, T3, T4: 2N3904; TO92
U$1: ILI9341

Connections:
+3V3: C5.1, C8.+, IC1.5 (VCC), IC1.17 (VCC), IC1.27 (AVCC), IC1.29 (AREF), IC1.38 (VCC), IC2.2 (OUTPUT), IC2.4 (VOUT), JP8.6, R1.2, R3.2, R5.2, R8.1, R10.2, R11.2, R12.2, SV1.4, U$1.VCC
+5V: C4.+, IC2.3 (INPUT), JP5.1
ADAPTER_BAT: IC1.36 ((PCINT1/ADC1)PA1), R9.2, SV1.5
ADC3: IC1.34 ((PCINT3/ADC3)PA3), R15.1, R16.2
ADC4: C7.1, IC1.33 ((PCINT4/ADC4)PA4), Q2.3 (S), R17.2
AUDIO_1: IC1.26 ((PCINT23/TOSC2)PC7), R13.2
AUDIO_2: IC1.25 ((PCINT22/TOSC1)PC6), R25.E
GND: C1.1, C2.1, C3.2, C4.-, C5.2, C6.-, C7.2, C8.-, IC1.6 (GND), IC1.18 (GND), IC1.28 (GND), IC1.39 (GND), IC2.1 (ADJ/GND), JP1.2, JP2.2, JP3.2, JP4.3, JP5.2, JP6.3, JP8.2, LED1.K (C), LED2.K (C), LED3.K (C), R9.1, R16.1, R17.1, R25.A, S1.3, S1.4 (P1), SG1.- (2), SV1.3, U$1.GND
LED_GREEN: IC1.43 ((PCINT11/OC0A/AIN1)PB3), R6.2
LED_ORANGE: IC1.41 ((PCINT9/CLKO/T1)PB1), R4.2
LED_RED: IC1.42 ((PCINT10/INT2/AIN0)PB2), R2.2
MISO: IC1.2 ((PCINT14/MISO)PB6), JP8.5, U$1.SDO(MISO), U$1.SD_MISO
MOSI: IC1.1 ((PCINT13/MOSI)PB5), JP8.1, U$1.SDI(MOSI), U$1.SD_MOSI
unnamed: R1.1, T1.1 (C)
unnamed: R2.1, T1.2 (B)
unnamed: LED1.A, T1.3 (E)
unnamed: LED2.A, T4.3 (E)
unnamed: R4.1, T4.2 (B)
unnamed: R3.1, T4.1 (C)
unnamed: R5.1, T2.1 (C)
unnamed: R6.1, T2.2 (B)
unnamed: LED3.A, T2.3 (E)
unnamed: R7.1, U$1.LED
unnamed: C1.2, IC1.7 (XTAL2), Q1.2
unnamed: R8.2, S1.1 (S)
unnamed: R13.1, T3.2 (B)
unnamed: SG1.+ (1), T3.1 (C)
unnamed: C2.2, IC1.8 (XTAL1), Q1.1
unnamed: C6.+, JP6.1, JP6.2, R25.S, T3.3 (E)
unnamed: C3.1, Q2.1 (G), R14.1
PWM: IC1.15 ((PCINT30/OC2B/ICP)PD6), R14.2
RESET: IC1.4 (RESET), JP8.3, S1.2 (S1), U$1.RESET
RX: IC1.9 ((PCINT24/RXD0)PD0), JP4.2
SCK: IC1.3 ((PCINT15/SCK)PB7), JP8.4, U$1.SCK, U$1.SD_SCK
SD_CS: IC1.44 ((PCINT12/OC0B/!SS!)PB4), U$1.SD_CS
TASTER_1: IC1.22 ((PCINT19/TMS)PC3), JP2.1, R11.1
TASTER_2: IC1.23 ((PCINT20/TDO)PC4), JP3.1, R12.1
TASTER_3: IC1.24 ((PCINT21/TDI)PC5), JP1.1, R10.1
TFT_CS: IC1.11 ((PCINT26/INT0)PD2), U$1.CS
TFT_DC: IC1.13 ((PCINT28/OC1B)PD4), U$1.DC
TFT_LED: IC1.14 ((PCINT29/OC1A)PD5), R7.2
TST_BAT: IC1.35 ((PCINT2/ADC2)PA2), SV1.1
TX: IC1.10 ((PCINT25/TXD0)PD1), JP4.1
V_BAT: Q2.2 (D), R15.2, SV1.2

Notes on the sheet:
RX & TX

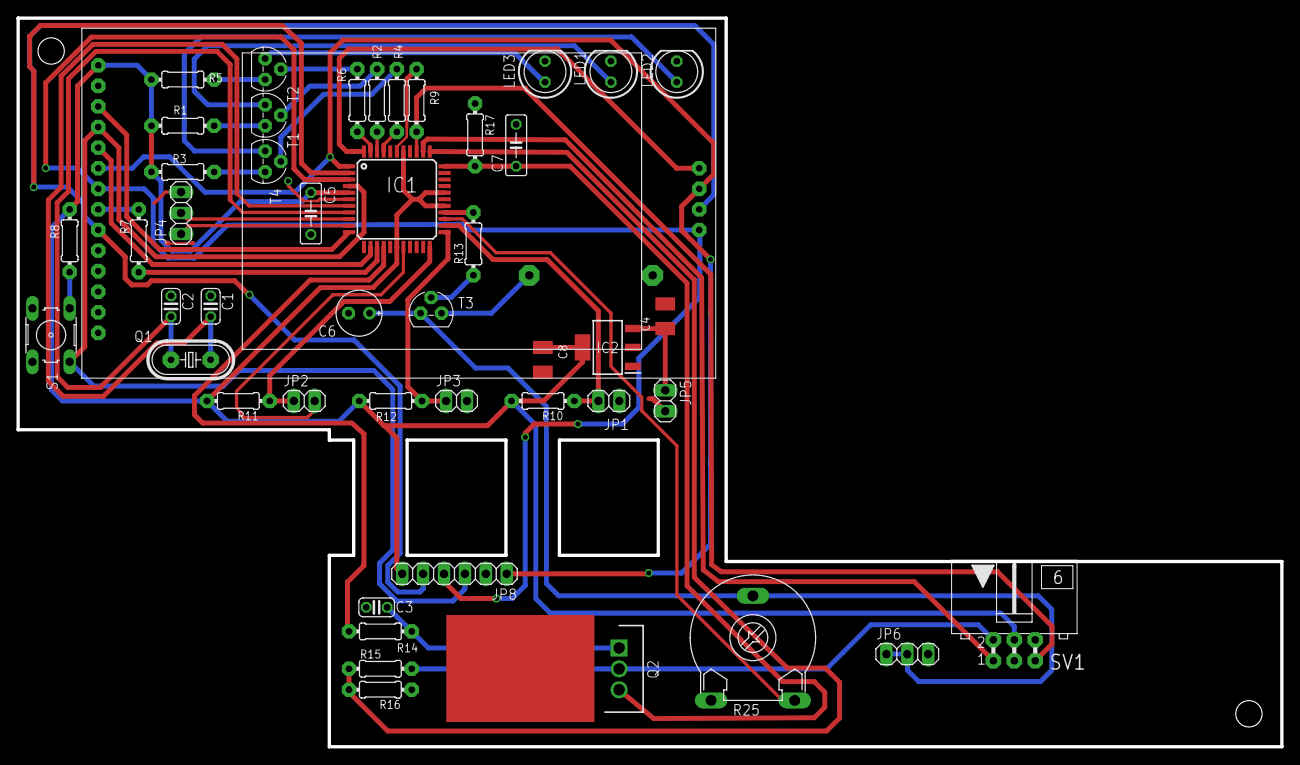
[picture p29: board BTG.brd from above]

Board: 2 copper layers, 153.5 x 88.5 mm, 48 parts (1 on the bottom side), 44 nets.
