RDPOLL/BTG/Achtung.h

/*
	Author: Lucas Pollak
	Date: 	25.11.2020
	Description:
	Bitmap for cautionsign
*/
#define Achtung_width 30
#define Achtung_height 30
static const unsigned char Achtung_bits[] PROGMEM = {
   0x00, 0x00, 0x00, 0x00, 0x00, 0xc0, 0x00, 0x00, 0x00, 0xe0, 0x01, 0x00,
   0x00, 0xe0, 0x01, 0x00, 0x00, 0xf0, 0x03, 0x00, 0x00, 0xf0, 0x03, 0x00,
   0x00, 0x38, 0x07, 0x00, 0x00, 0x38, 0x07, 0x00, 0x00, 0x1c, 0x0e, 0x00,
   0x00, 0x1c, 0x0e, 0x00, 0x00, 0x0e, 0x1c, 0x00, 0x00, 0x0e, 0x1c, 0x00,
   0x00, 0x07, 0x38, 0x00, 0x00, 0x07, 0x38, 0x00, 0x80, 0x03, 0x70, 0x00,
   0x80, 0x03, 0x70, 0x00, 0xc0, 0x01, 0xe0, 0x00, 0xc0, 0x01, 0xe0, 0x00,
   0xe0, 0x00, 0xc0, 0x01, 0xe0, 0x00, 0xc0, 0x01, 0x70, 0x00, 0x80, 0x03,
   0x70, 0x00, 0x80, 0x03, 0x38, 0x00, 0x00, 0x07, 0x38, 0x00, 0x00, 0x07,
   0x1c, 0x00, 0x00, 0x0e, 0x1c, 0x00, 0x00, 0x0e, 0x1e, 0xa9, 0x44, 0x1e,
   0xfe, 0xff, 0xff, 0x1f, 0xfe, 0xff, 0xff, 0x1f, 0xfc, 0xff, 0xff, 0x0f };
