RDPOLL/BTG/Gear.h

/*
	Author: Lucas Pollak
	Date: 	25.11.2020
	Description:
	Bitmap for gearsign
*/
#define Gear_width 30
#define Gear_height 30
static const unsigned char Gear_bits[] PROGMEM = {
   0x00, 0xf0, 0x03, 0x00, 0x00, 0xf0, 0x03, 0x00, 0x00, 0xf0, 0x03, 0x00,
   0xe0, 0xf8, 0xc7, 0x01, 0xf0, 0xff, 0xff, 0x03, 0xf8, 0xff, 0xff, 0x07,
   0xf8, 0xff, 0xff, 0x07, 0xf8, 0xff, 0xff, 0x07, 0xf0, 0xff, 0xff, 0x03,
   0xf0, 0x1f, 0xfe, 0x03, 0xf0, 0x07, 0xf8, 0x03, 0xf8, 0x03, 0xf0, 0x07,
   0xff, 0x03, 0xf0, 0x3f, 0xff, 0x01, 0xe0, 0x3f, 0xff, 0x01, 0xe0, 0x3f,
   0xff, 0x01, 0xe0, 0x3f, 0xff, 0x01, 0xe0, 0x3f, 0xff, 0x03, 0xf0, 0x3f,
   0xf8, 0x03, 0xf0, 0x07, 0xf0, 0x07, 0xf8, 0x03, 0xf0, 0x1f, 0xfe, 0x03,
   0xf0, 0xff, 0xff, 0x03, 0xf8, 0xff, 0xff, 0x07, 0xf8, 0xff, 0xff, 0x07,
   0xf8, 0xff, 0xff, 0x07, 0xf0, 0xff, 0xff, 0x03, 0xe0, 0xf8, 0xc7, 0x01,
   0x00, 0xf0, 0x03, 0x00, 0x00, 0xf0, 0x03, 0x00, 0x00, 0xf0, 0x03, 0x00 };
