RDPOLL/BTG/Stop.h

/*
	Author: Lucas Pollak
	Date: 	25.11.2020
	Description:
	Bitmap for Stopsign
*/
#define Stop_width 30
#define Stop_height 30
static const unsigned char Stop_bits[] PROGMEM = {
   0x00, 0x00, 0x00, 0x00, 0x00, 0xfe, 0x1f, 0x00, 0x00, 0x01, 0x20, 0x00,
   0x80, 0x00, 0x40, 0x00, 0x40, 0xe0, 0x80, 0x00, 0x20, 0xa0, 0x01, 0x01,
   0x10, 0x3c, 0x07, 0x02, 0x08, 0x24, 0x0d, 0x04, 0x04, 0x27, 0x05, 0x08,
   0x02, 0x25, 0x0d, 0x10, 0x02, 0x25, 0x05, 0x10, 0x02, 0x25, 0xcd, 0x11,
   0x82, 0x25, 0xe5, 0x10, 0x02, 0x25, 0xad, 0x11, 0x82, 0xb4, 0x95, 0x10,
   0x02, 0x05, 0xdc, 0x10, 0x82, 0x01, 0x48, 0x10, 0x02, 0x01, 0x42, 0x10,
   0x82, 0x01, 0x21, 0x10, 0x02, 0x81, 0x20, 0x10, 0x02, 0x01, 0x10, 0x10,
   0x04, 0x41, 0x10, 0x08, 0x08, 0x83, 0x08, 0x04, 0x10, 0x06, 0x0c, 0x02,
   0x20, 0x9c, 0x02, 0x01, 0x40, 0xf0, 0x81, 0x00, 0x80, 0x00, 0x40, 0x00,
   0x00, 0x01, 0x20, 0x00, 0x00, 0xfe, 0x1f, 0x00, 0x00, 0x00, 0x00, 0x00 };
