RDPOLL/BTG/Volt.h

/*
	Author: Lucas Pollak
	Date: 	25.11.2020
	Description:
	Bitmap for measurementsign
*/
#define volt_width 30
#define volt_height 30
static const unsigned char volt_bits[] PROGMEM = {
   0x00, 0x00, 0x00, 0x00, 0x00, 0x00, 0x00, 0x00, 0xe0, 0xff, 0xff, 0x01,
   0xf8, 0xff, 0xff, 0x07, 0x08, 0x00, 0x00, 0x04, 0x0c, 0x00, 0x00, 0x0c,
   0x0c, 0xf8, 0x07, 0x0c, 0x0c, 0xcf, 0x3c, 0x0c, 0x8c, 0xc7, 0x78, 0x0c,
   0x6c, 0x04, 0x88, 0x0d, 0x6c, 0x00, 0x80, 0x0d, 0xcc, 0x00, 0xc0, 0x0c,
   0x0c, 0x10, 0x00, 0x0c, 0x0c, 0x10, 0x00, 0x0c, 0x0c, 0x10, 0x00, 0x0c,
   0x0c, 0x20, 0x00, 0x0c, 0x0c, 0x20, 0x00, 0x0c, 0x0c, 0x60, 0x00, 0x0c,
   0x0c, 0xe0, 0x01, 0x0c, 0x0c, 0x18, 0x06, 0x0c, 0xfc, 0x0f, 0xfc, 0x0f,
   0xfc, 0x07, 0xf8, 0x0f, 0x0c, 0xc0, 0x00, 0x0c, 0x0c, 0xc0, 0x00, 0x0c,
   0x0c, 0x00, 0x00, 0x0c, 0x08, 0x00, 0x00, 0x04, 0xf8, 0xff, 0xff, 0x07,
   0xe0, 0xff, 0xff, 0x01, 0x00, 0x00, 0x00, 0x00, 0x00, 0x00, 0x00, 0x00 };
