RDPOLL/BTG/(commit log)

2020-10-22 More cleanup, moved F_CPU to makefile so all delay.h are ok. Changes with adc -> include adc.h not adc.c Changes to keep gcc happy about declarations.
    modified: ADC.c
    modified: Makefile
    new file: adc.h
    modified: ili9341.c
    modified: main.c
2020-10-22 Consistent F_CPU (uart.c had a wrong definition ) now F_CPU only in Makefile change !!! More cleanup to keep gcc happy.
    modified: uart.c
    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
    [ili9341.c, uart.c]
2020-10-23 some more clean up (I2C removed)
2020-10-25 added chan's fatfs for sd support clean up will be needed as there are too many files. For now everything is added.
    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
2020-10-28 Modification due to adc conversations.
    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
2020-10-31 Added doc dir, added icons for graphics, added write support, put ifdef around uneeded function to make smaller image.
    new file: Achtung.h
    new file: Stop.h
    new file: doc/cur.dat
    new file: doc/main.png
    new file: doc/prg_flow.dot
    new file: doc/read.ini
    new file: doc/volt.dat
    modified: fatfs/ffconf.h
    modified: fatfs/mmc_avr_spi.c
    modified: ili9341.h
    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
2020-10-31 Cleanup for end user, added "failed"/"passed" field in csv. Now the display changes when batery failes or passes.
    modified: README.md
    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
    [main.c]
2020-10-31 Forgat Volt.h new file: Volt.h
2020-11-05 Forgat Gear.h to add. new file: Gear.h modified: Makefile modified: main.c
2020-11-05 Added delay after power up SD Card... just to relax time for the card modified: fatfs/mmc_avr_spi.c
2020-11-05 increased delay after power on... SD Specifications say up to 35ms .. so increased it to 100ms modified: fatfs/mmc_avr_spi.c
2020-11-05 Forgat add PROGMEM in Gear.h And.. Fixed SD Card Proble @ powerup. Looks like some Cards need more time or clk cycles to fully start.. So there is now a retry_cnt, if initialisation fail first, it tr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
    [Gear.h]
2020-12-02 added Doku
    [Adapter_6V.stl, BTG.brd, BTG.sch, Batterietestgeraet_Aluplatte.ipt, Bauteilliste.xlsx, Deckel_Schalter.stl]
2020-12-03 Doku updated
    [BTG.brd, BTG.sch]
